jnedbal/pulse_stretcher/img/bottomPCB.png

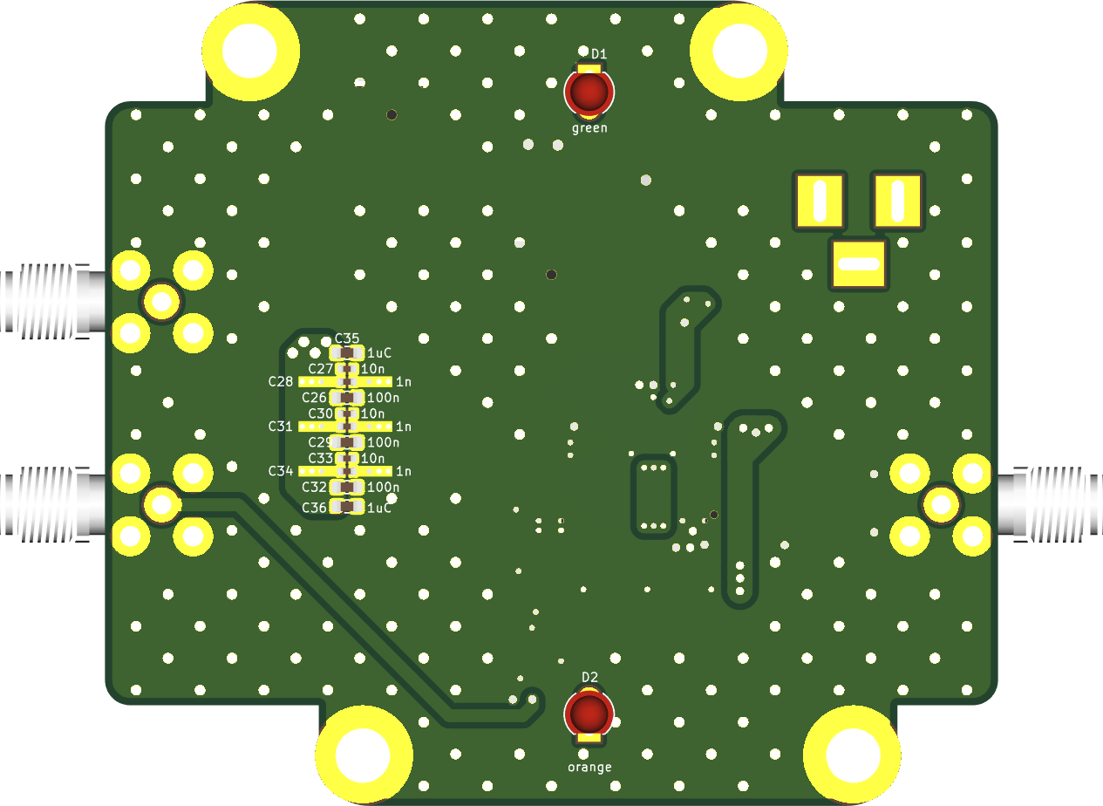
img/bottomPCB.png
