jnedbal/pulse_stretcher/img/topPCB.png

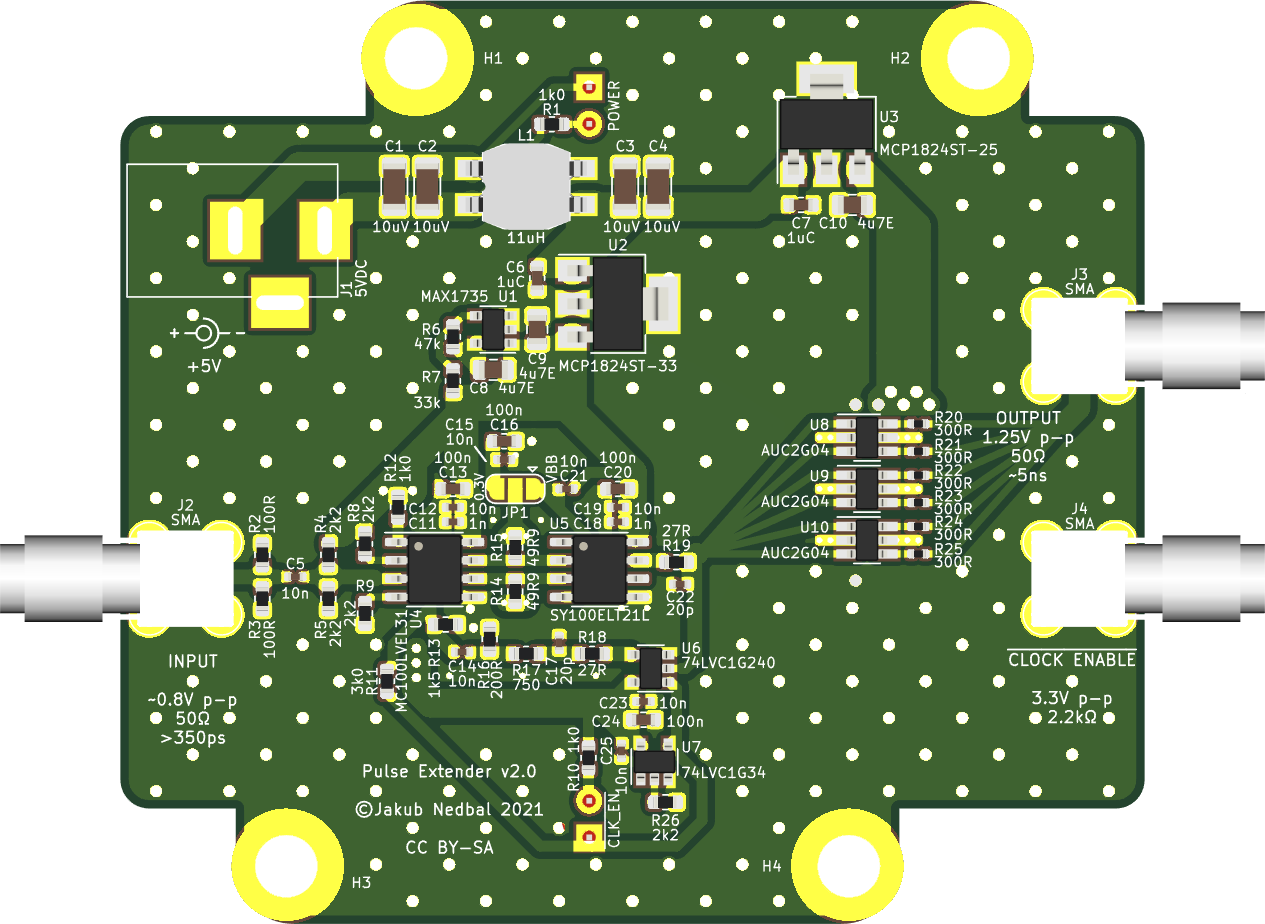
img/topPCB.png
