jnedbal/pulse_stretcher/pulse_stretcher.kicad_pcb

## KiCad design pulse_stretcher.kicad_pcb (2021-11-15)

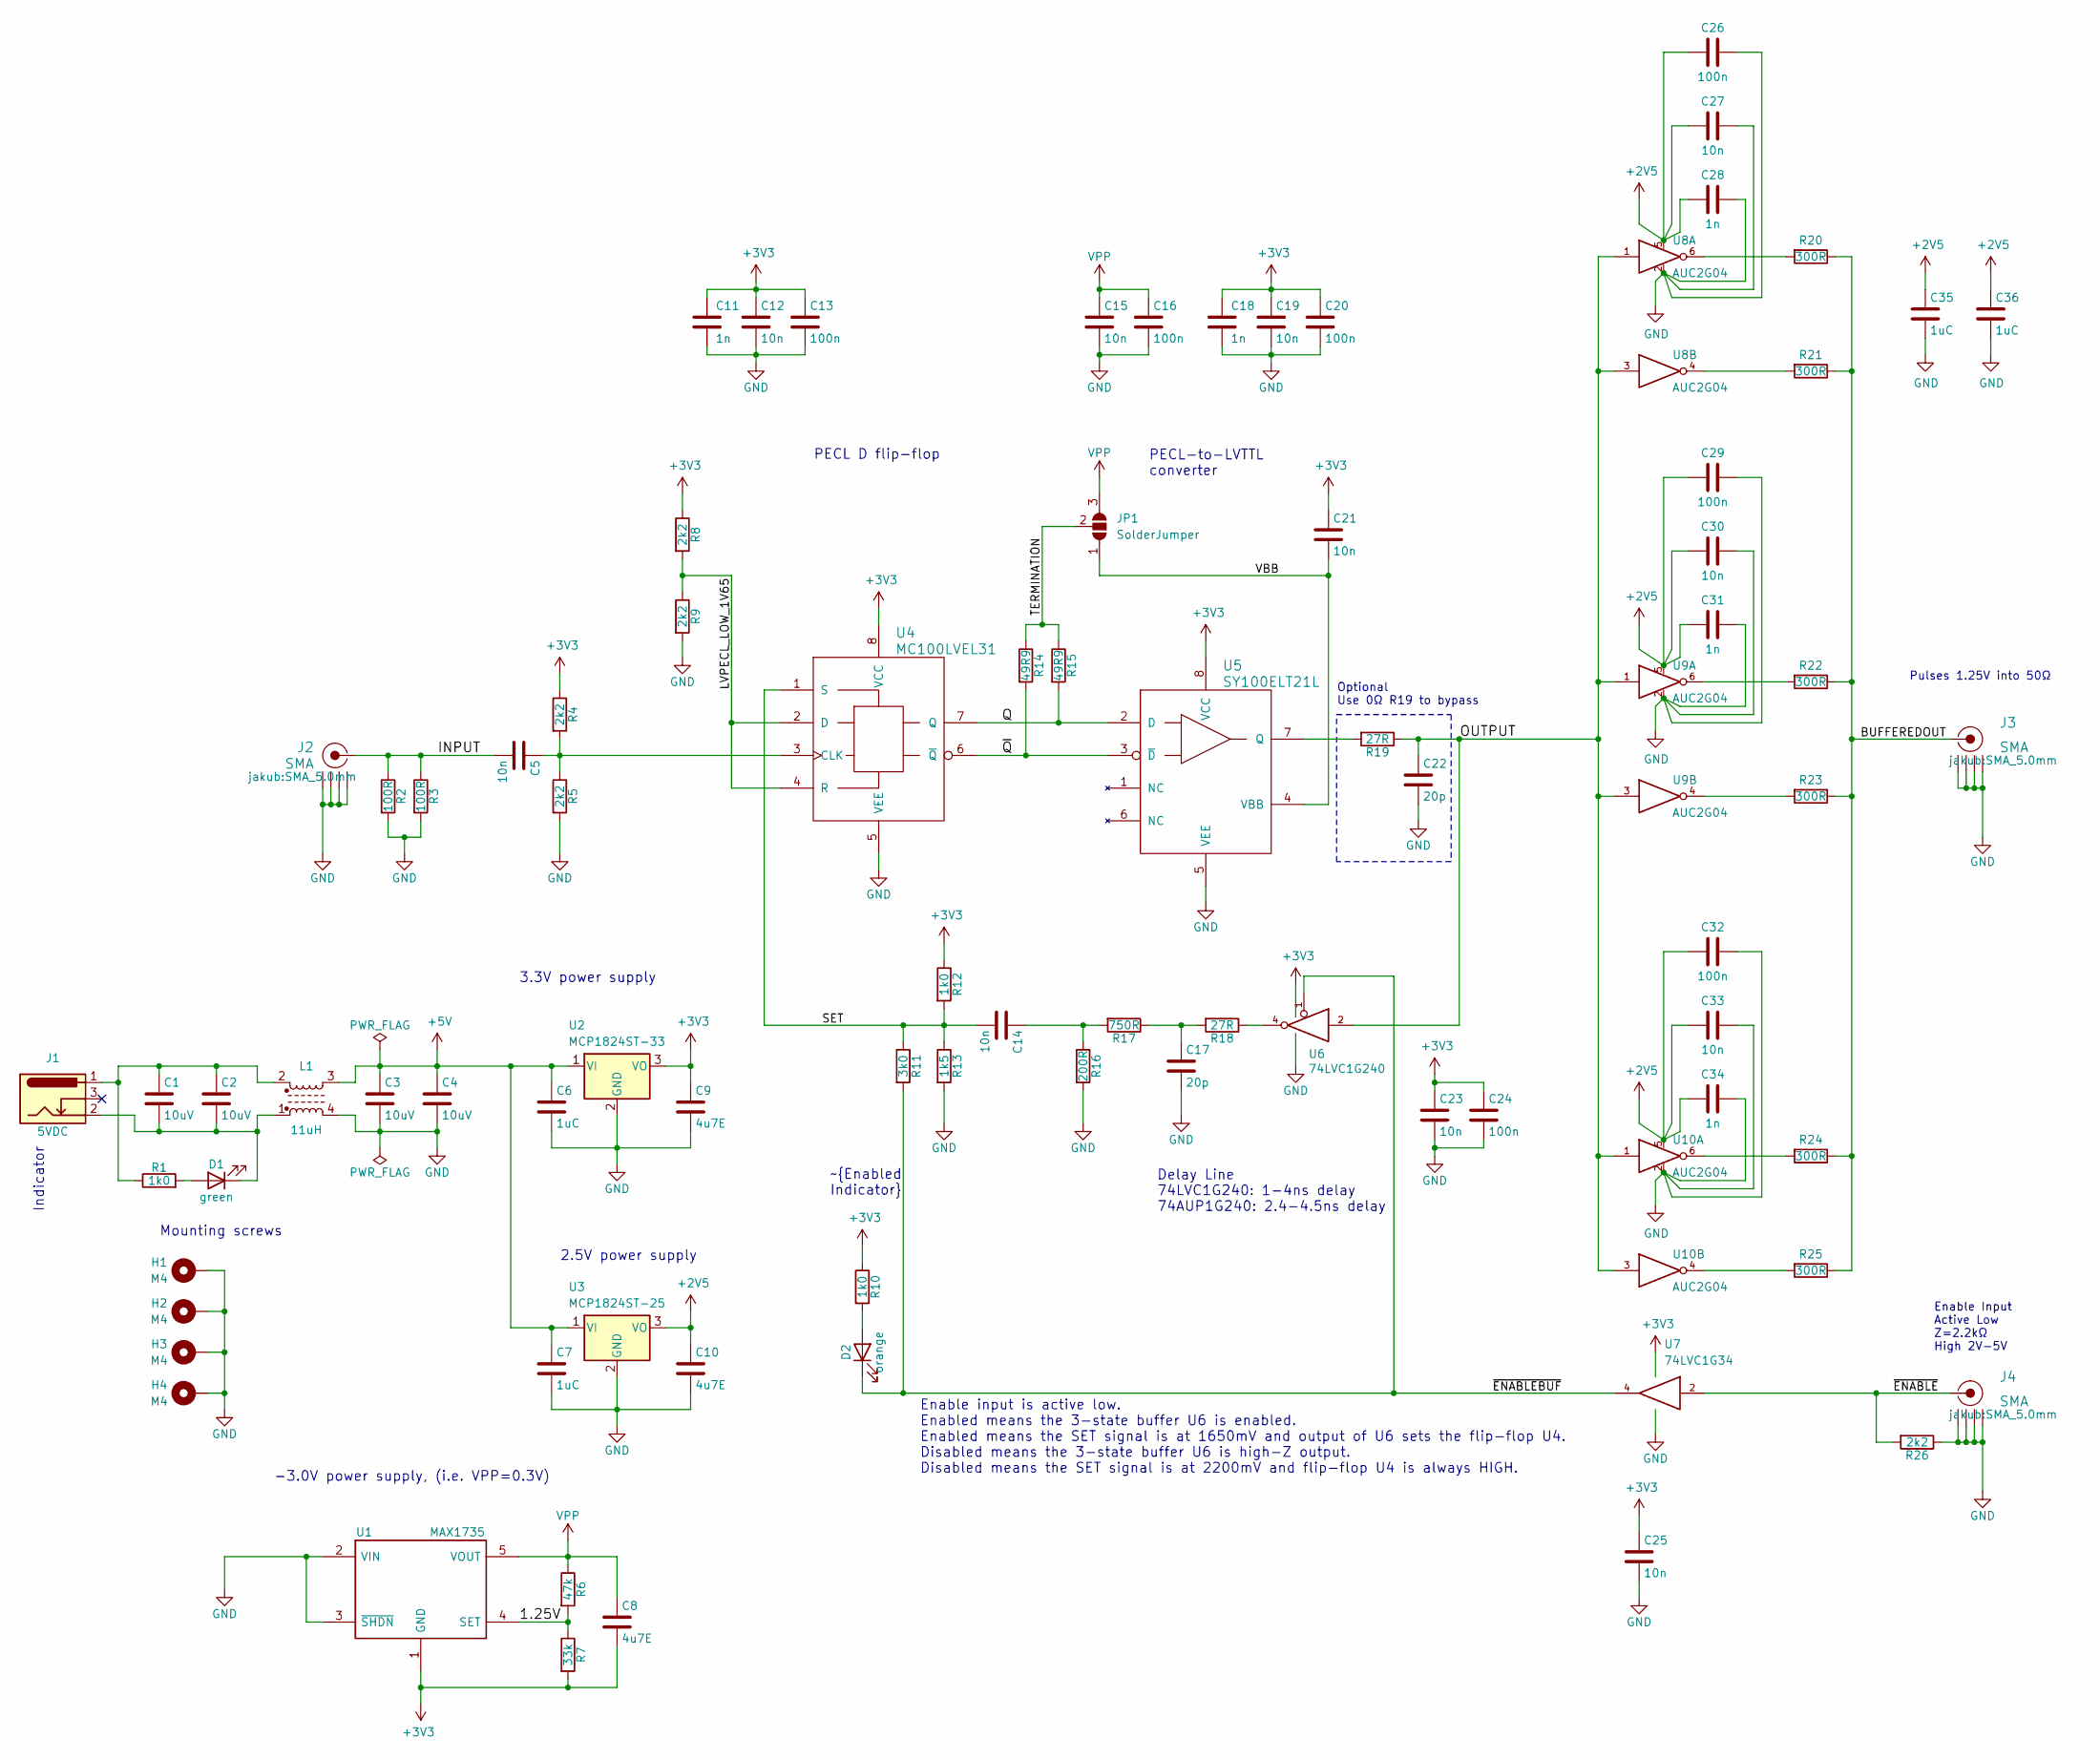
[picture p3: schematic pulse_stretcher.sch, Pulse Stretcher]

Parts:
C1, C2, C3, C4: 10uV; C_1206_3216Metric; Part Number GMK316AB7106KL-TR
C5, C12, C14, C15, C19, C21, C23, C25, C27, C30, C33: 10n; C_0402_1005Metric; Part Number C0402C103K5RACTU
C6, C7, C35, C36: 1uC; C_0603_1608Metric; Part Number GRM188R61E105K
C8, C9, C10: 4u7E; C_0805_2012Metric; Part Number C2012X5R1E475K125AB
C11, C18, C28, C31, C34: 1n; C_0402_1005Metric; Part Number GRM1555C1H102JA01D
C13, C16, C20, C24, C26, C29, C32: 100n; C_0603_1608Metric; Part Number C1608X7R1H104M080AA
C17, C22: 20p; C_0603_1608Metric; Part Number MC0603N200J500CT
D1: green; LED_D3.0mm; Part Number KPT-1608SECK
D2: orange; LED_D3.0mm; Part Number KPT-1608SECK
H1, H2, H3, H4: M4; MountingHole_4.3mm_M4_Pad
J1: 5VDC; BARREL_JACK; Part Number FC681465
J2, J3, J4: SMA; SMA_5.0mm; Part Number 5-1814400-1
JP1: SolderJumper; SolderJumper-3_P1.3mm_Open_RoundedPad1.0x1.5mm
L1: 11uH; DR334A; Part Number DR334A-113BE
R1, R10, R12: 1k0; R_0603_1608Metric; Part Number RC0603FR-071KL
R2, R3: 100R; R_0603_1608Metric; Part Number MCWR06X1000FTL
R4, R5, R8, R9, R26: 2k2; R_0603_1608Metric; Part Number RC0603FR-072K2L
R6: 47k; R_0603_1608Metric; Part Number MCWR06X4702FTL
R7: 33k; R_0603_1608Metric; Part Number MCWR06X3302FTL
R11: 3k0; R_0603_1608Metric; Part Number RC0603FR-073KL
R13: 1k5; R_0603_1608Metric; Part Number RC0603FR-071K5L
R14, R15: 49R9; R_0603_1608Metric; Part Number MCWR06X49R9FTL
R16: 200R; R_0603_1608Metric; Part Number RC0603FR-07200RL
R17: 750R; R_0603_1608Metric; Part Number RC0603FR-07750RL
R18, R19: 27R; R_0603_1608Metric; Part Number MCWR06X27R0FTL
R20, R21, R22, R23, R24, R25: 300R; R_0402_1005Metric; Part Number MCWR04X3000FTL
U1: MAX1735; SOT-23-5; Part Number MAX1735EUK50+T
U2: MCP1824ST-33; SOT-223-3_TabPin2; Part Number MCP1824ST-3302E/DB
U3: MCP1824ST-25; SOT-223-3_TabPin2; Part Number MCP1824ST-2502E/DB
U4: MC100LVEL31; SOIC-8_3.9x4.9mm_P1.27mm; Part Number MC100LVEL31DG
U5: SY100ELT21L; SOIC-8_3.9x4.9mm_P1.27mm; Part Number SY100ELT21LZG
U6: 74LVC1G240; SOT-23-5; Part Number SN74LVC1G240DBVR
U7: 74LVC1G34; SOT-23-5; Part Number SN74LVC1G34DBVT
U8, U9, U10: AUC2G04; SOT-23-6_Handsoldering; Part Number SN74AUC2G04DBVR

Connections:
+2V5: C10.1, C26.2, C27.2, C28.1, C29.2, C30.2, C31.1, C32.2, C33.2, C34.1, C35.1, C36.1, U3.3 (VO), U8.5, U9.5, U10.5
+3V3: C8.2, C9.1, C11.1, C12.1, C13.1, C18.1, C19.1, C20.1, C21.1, C23.1, C24.1, C25.1, R4.1, R7.2, R8.1, R10.1, R12.1, U1.1 (GND), U2.3 (VO), U4.8 (VCC), U5.8 (VCC), U6.5 (VCC), U7.5 (VCC)
+5V: C3.1, C4.1, C6.1, C7.1, L1.3, U2.1 (VI), U3.1 (VI)
/1.25V: R6.2, R7.1, U1.4 (SET)
/BUFFEREDOUT: J3.1 (RF), R20.1, R21.1, R22.1, R23.1, R24.1, R25.1
/INPUT: C5.2, J2.1 (RF), R2.1, R3.1
/LVPECL_LOW_1V65: R8.2, R9.1, U4.2 (D), U4.4 (R)
/OUTPUT: C22.1, R19.1, U6.2, U8.1, U8.3, U9.1, U9.3, U10.1, U10.3
/Q: R15.2, U4.7 (Q), U5.2 (D)
/SET: C14.2, R11.1, R12.2, R13.1, U4.1 (S)
/TERMINATION: JP1.2 (C), R14.1, R15.1
/VBB: C21.2, JP1.1 (A), U5.4 (VBB)
/~ENABLE: J4.1 (RF), R26.2, U7.2
/~ENABLEBUF: D2.1 (K), R11.2, U6.1, U7.4
/~Q: R14.2, U4.6 (~Q), U5.3 (~D)
GND: C3.2, C4.2, C6.2, C7.2, C9.2, C10.2, C11.2, C12.2, C13.2, C15.2, C16.2, C17.2, C18.2, C19.2, C20.2, C22.2, C23.2, C24.2, C25.2, C26.1, C27.1, C28.2, C29.1, C30.1, C31.2, C32.1, C33.1, C34.2, C35.2, C36.2, H1.1, H2.1, H3.1, H4.1, J2.2 (GND1), J2.3 (GND2), J2.4 (GND3), J2.5 (GND4), J3.2 (GND1), J3.3 (GND2), J3.4 (GND3), J3.5 (GND4), J4.2 (GND1), J4.3 (GND2), J4.4 (GND3), J4.5 (GND4), L1.4, R2.2, R3.2, R5.2, R9.2, R13.2, R16.2, R26.1, U1.2 (VIN), U1.3 (~SHDN), U2.2 (GND), U3.2 (GND), U4.5 (VEE), U5.5 (VEE), U6.3 (GND), U7.3 (GND), U8.2, U9.2, U10.2
unnamed: C1.1, C2.1, J1.1, L1.2, R1.1
unnamed: C1.2, C2.2, D1.1 (K), J1.2, L1.1
unnamed: C5.1, R4.2, R5.1, U4.3 (CLK)
unnamed: C14.1, R16.1, R17.2
unnamed: C17.1, R17.1, R18.2
unnamed: D1.2 (A), R1.2
unnamed: D2.2 (A), R10.2
unnamed: R18.1, U6.4
unnamed: R19.2, U5.7 (Q)
unnamed: R20.2, U8.6
unnamed: R21.2, U8.4
unnamed: R22.2, U9.6
unnamed: R23.2, U9.4
unnamed: R24.2, U10.6
unnamed: R25.2, U10.4
VPP: C8.1, C15.1, C16.1, JP1.3 (B), R6.1, U1.5 (VOUT)

Notes on the sheet:
3.3V power supply
-3.0V power supply, (i.e. VPP=0.3V)
Delay Line 74LVC1G240: 1-4ns delay 74AUP1G240: 2.4-4.5ns delay
PECL D flip-flop
PECL-to-LVTTL converter
Mounting screws
Indicator
2.5V power supply
Pulses 1.25V into 50Ω
Enable input is active low. Enabled means the 3-state buffer U6 is enabled. Enabled means the SET signal is at 1650mV and output of U6 sets the flip-flop U4. Disabled means the 3-state buffer U6 is high-Z output. Disabled means the SET signal is at 2200mV and flip-flop U4 is always HIGH.
Enable Input Active Low Z=2.2kΩ High 2V-5V
~Enabled Indicator
Optional Use 0Ω R19 to bypass

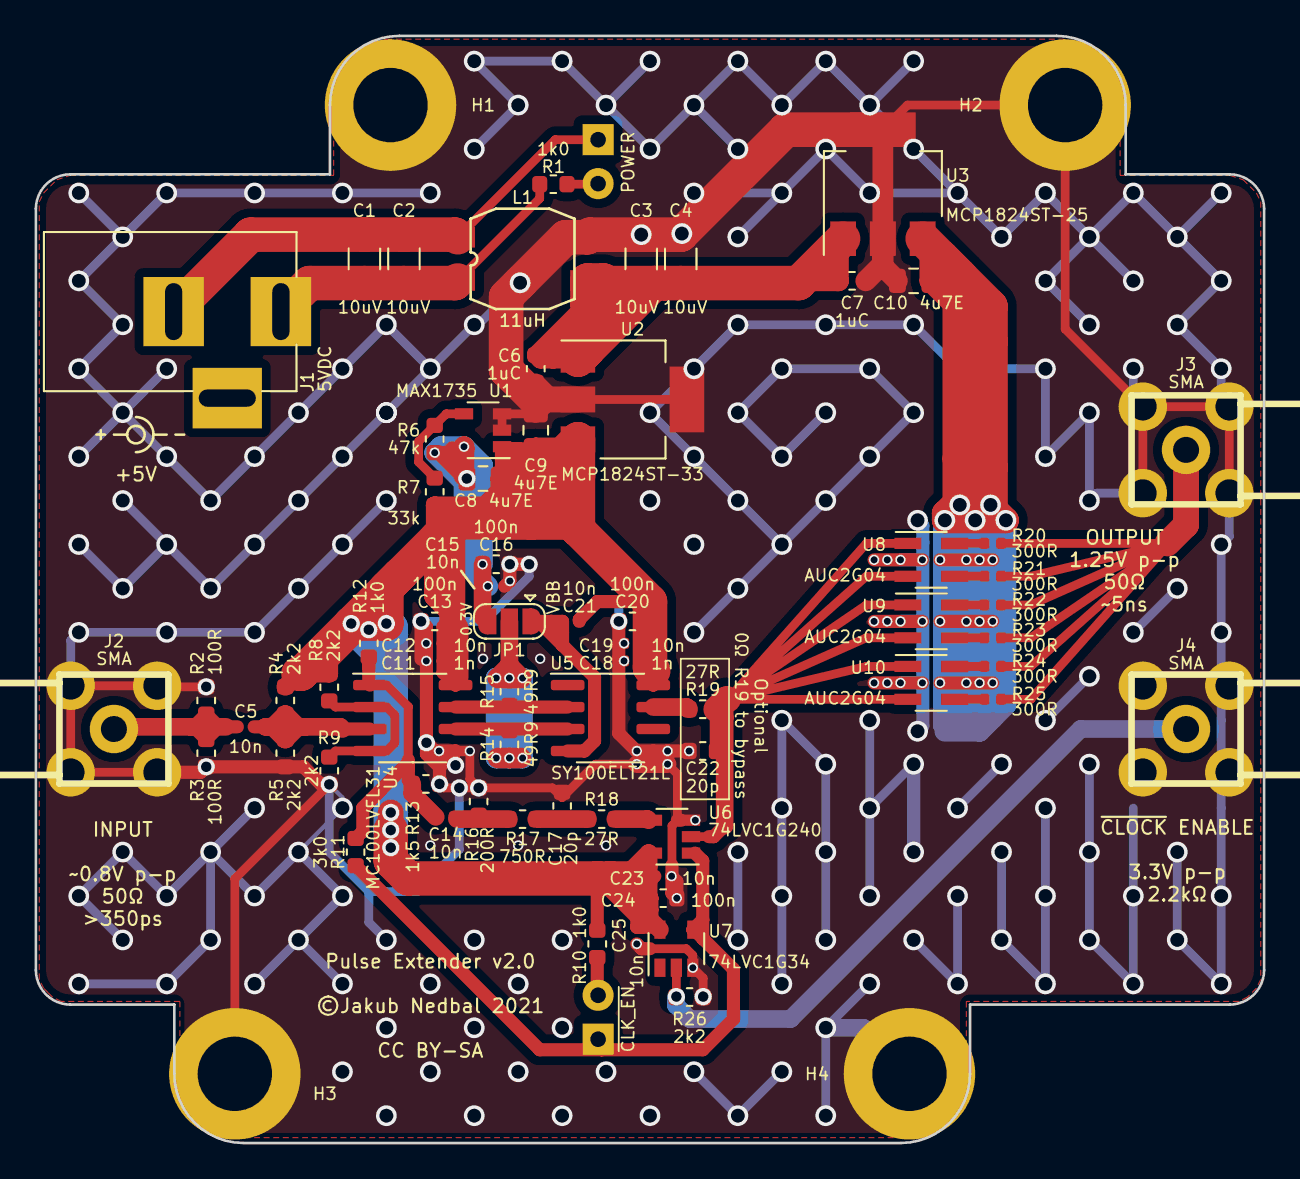
[picture p4: board pulse_stretcher.kicad_pcb from above]

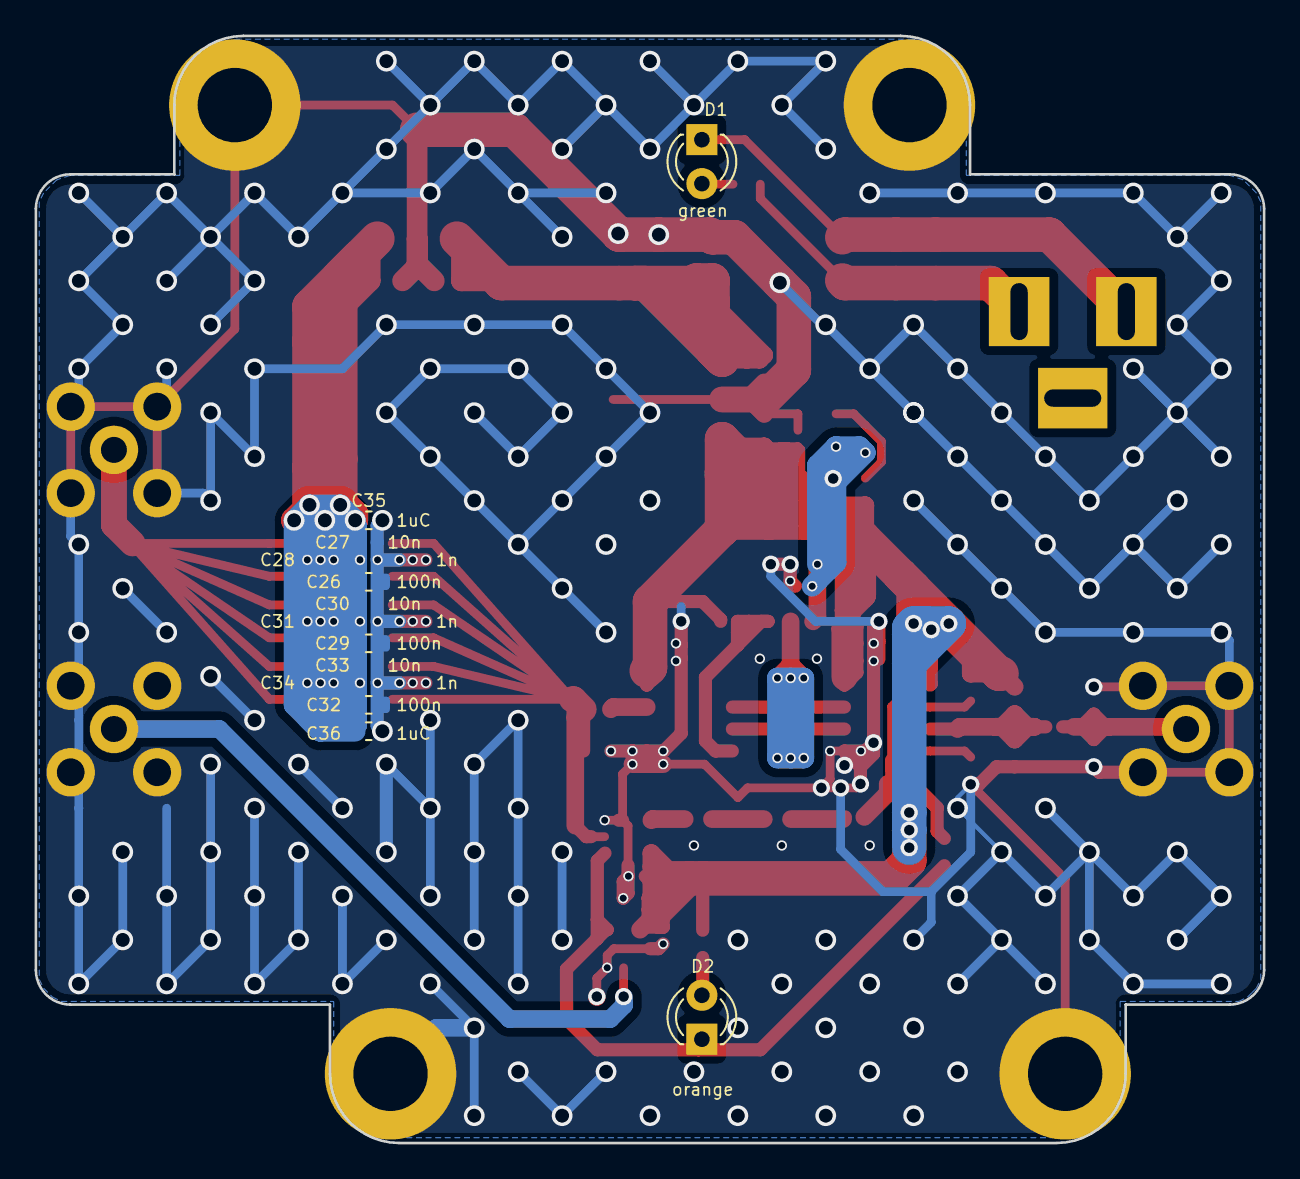
[picture p5: board pulse_stretcher.kicad_pcb from below]

Board: 2 copper layers, 71.0 x 64.0 mm, 84 parts (13 on the bottom side), 32 nets.
