jnedbal/pulse_stretcher/(commit log)

2021-11-09 Initial commit. Waiting on parts to check board will fit the box.
    [pulse_stretcher.sch, pulse_stretchergrouped.csv]
2021-11-12 Redesigned the PCB
    [pulse_stretcher.kicad_pcb, pulse_stretcher.sch, pulse_stretchergrouped.csv]
2021-11-12 Added ~clock_enable
    [pulse_stretcher.kicad_pcb, pulse_stretcher.sch, pulse_stretchergrouped.csv]
2021-11-12 Added comment about RC filter being optional
    [pulse_stretcher.kicad_pcb, pulse_stretcher.sch]
2021-11-15 Production run
    [pulse_stretcher-B_Cu.gbl, pulse_stretcher-B_Mask.gbs, pulse_stretcher-B_SilkS.gbo, pulse_stretcher-Edge_Cuts.gm1, pulse_stretcher-F_Cu.gtl, pulse_stretcher-F_Mask.gts, pulse_stretcher-F_SilkS.gto, pulse_stretcher-job.gbrjob]
