jnedbal/pulse_stretcher/(notices)

Notices in the files:
pulse_stretcher.kicad_pcb:
©Jakub Nedbal 2021
CC BY-SA
pulse_stretcher.sch:
Creative Commons Attribution-ShareAlike 4.0 International License
This work is licensed under a
